tz61/ECE385FA24-PCB-ChampaignBoard/xc7s50-ece385-sch-v0.1.pdf

# XC7S50 Bank0

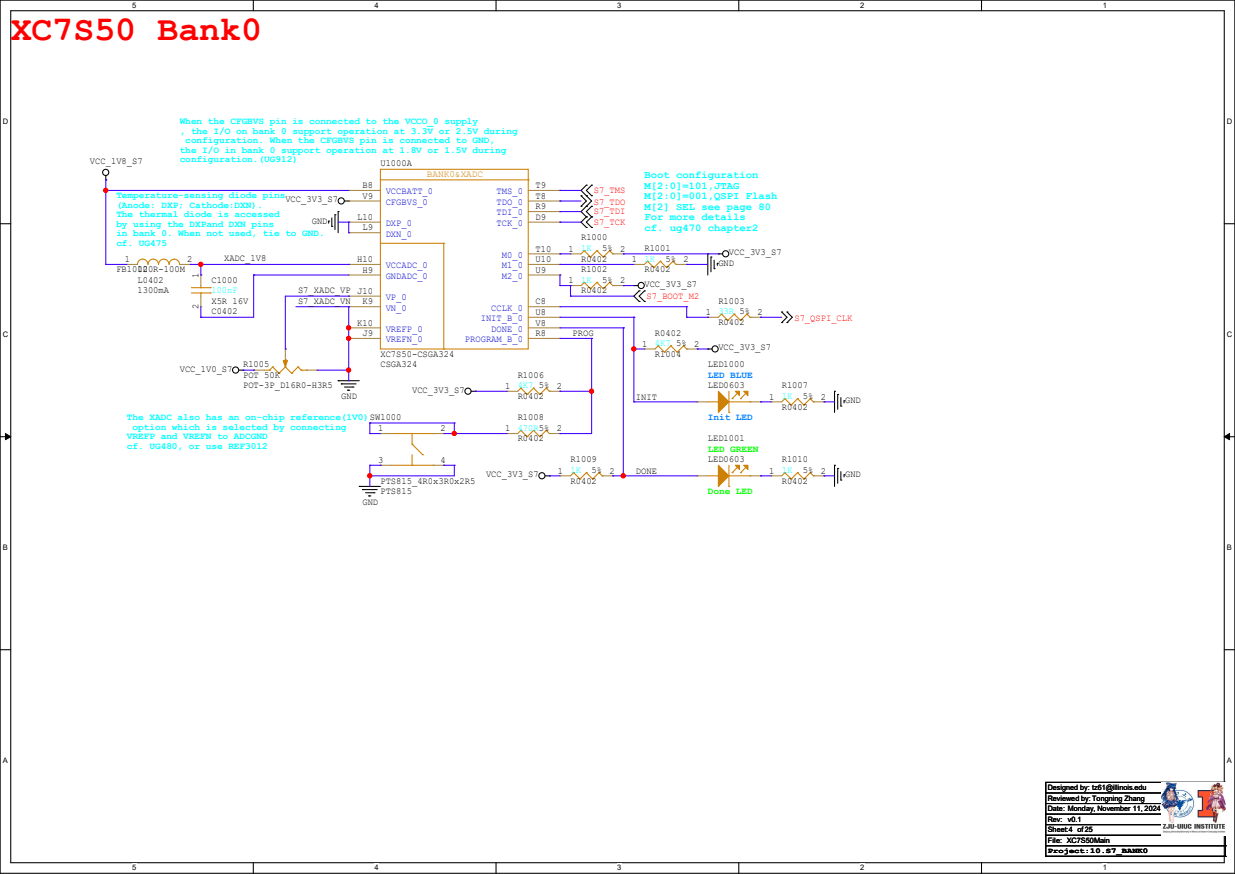
[picture p2: page 1]

When the CFGBVS pin is connected to the VCCO_0 supply
, the I/O on bank 0 support operation at 3.3V or 2.5V during
configuration. When the CFGBVS pin is connected to GND,
the I/O in bank 0 support operation at 1.8V or 1.5V during
configuration.(UG912)

Temperature-sensing diode pins
(Anode: DXP; Cathode:DXN).
The thermal diode is accessed
by using the DXPand DXN pins
in bank 0. When not used, tie to GND.

The XADC also has an on-chip reference(1V0)
option which is selected by connecting
VREFP and VREFN to ADCGND
cf. UG480, or use REF3012

File: Date: Designed by: Rev: Sheet: of Reviewed by:
Monday, November 11, 2024

# XC7S50 Bank14/15/16

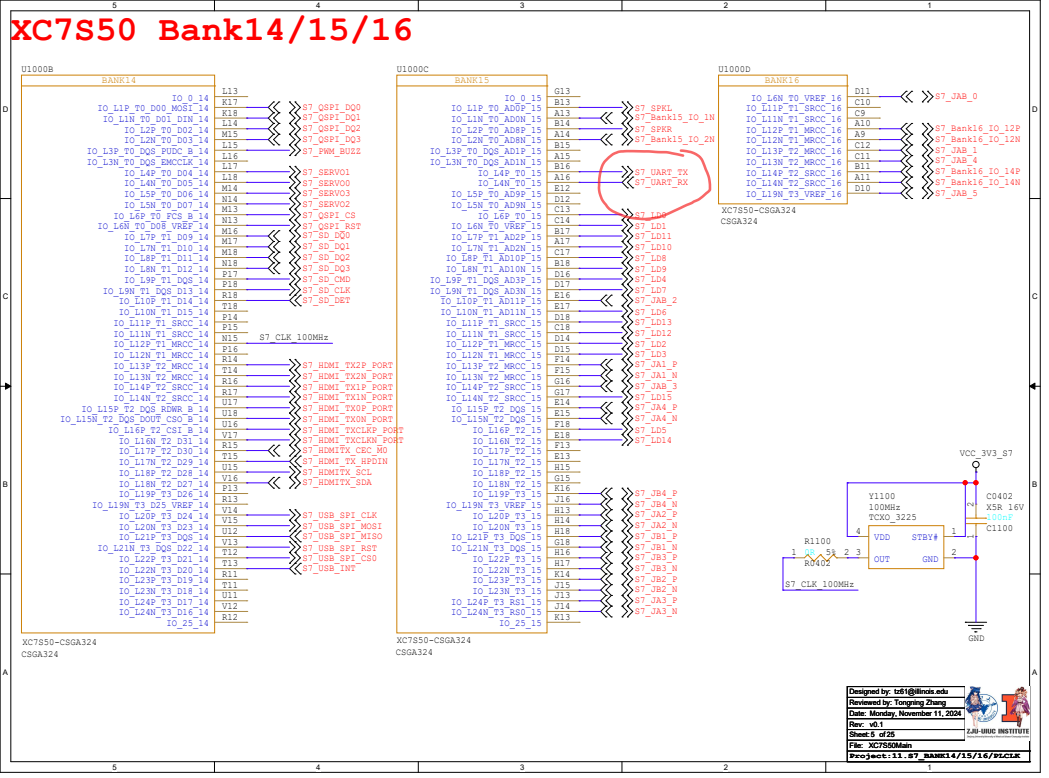
[picture p3: page 2]

File: Date: Designed by: Rev: Sheet: of Reviewed by:

# XC7S50 Bank34/35/DDRCLK

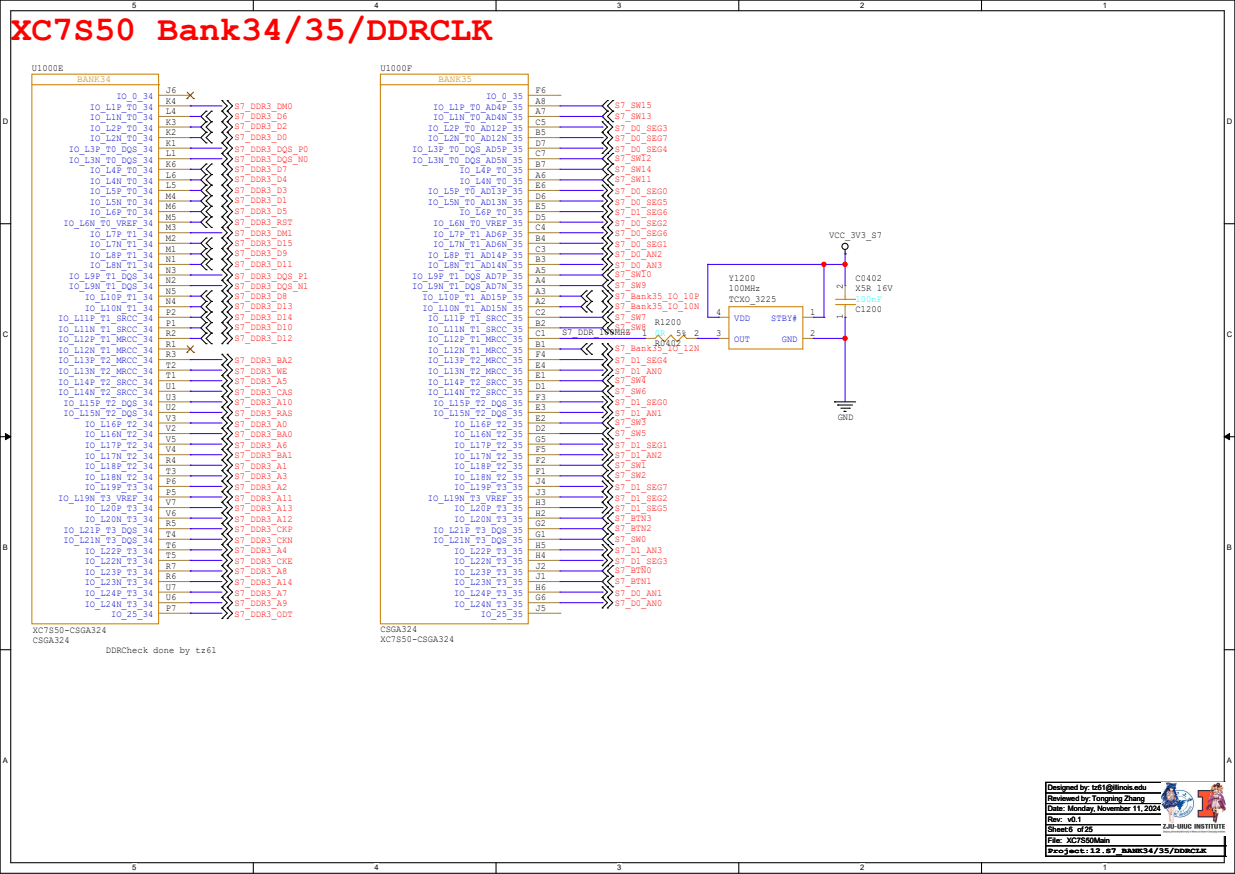
[picture p4: page 3]

File: Date: Designed by: Rev: Sheet: of Reviewed by:

# XC7S50 Power/Gnd

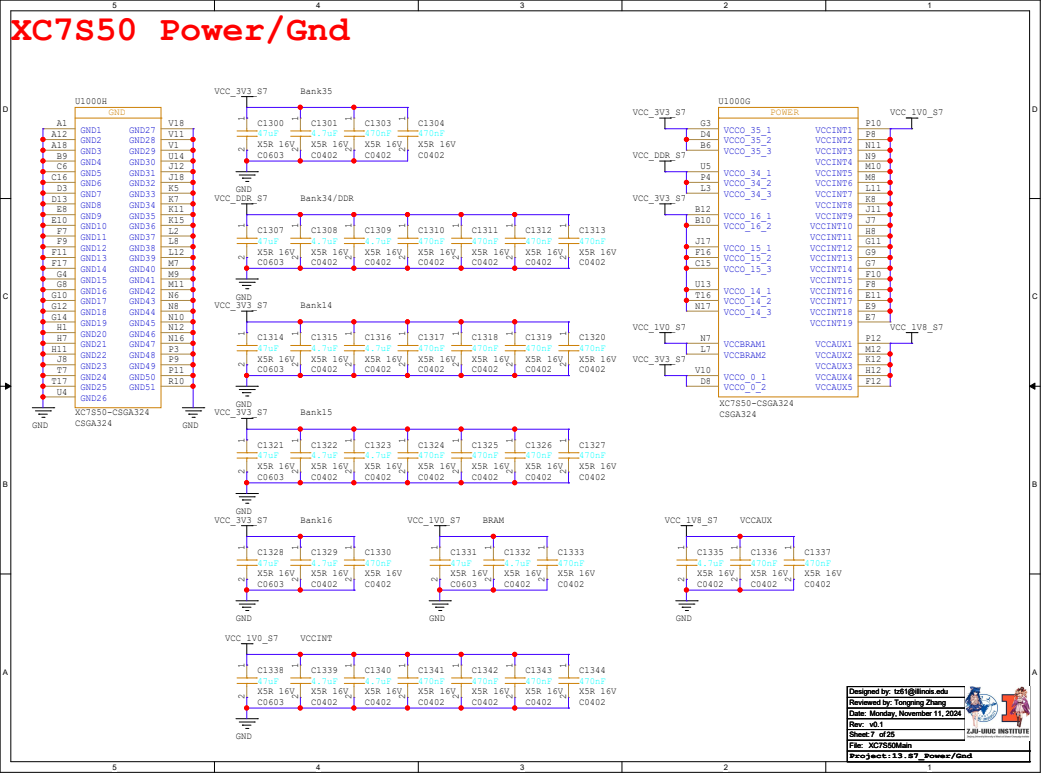
[picture p5: page 4]

File: Date: Designed by: Rev: Sheet: of Reviewed by:

# Power for Spartan7

# 5V Input/USB In(Type-C connector) GND

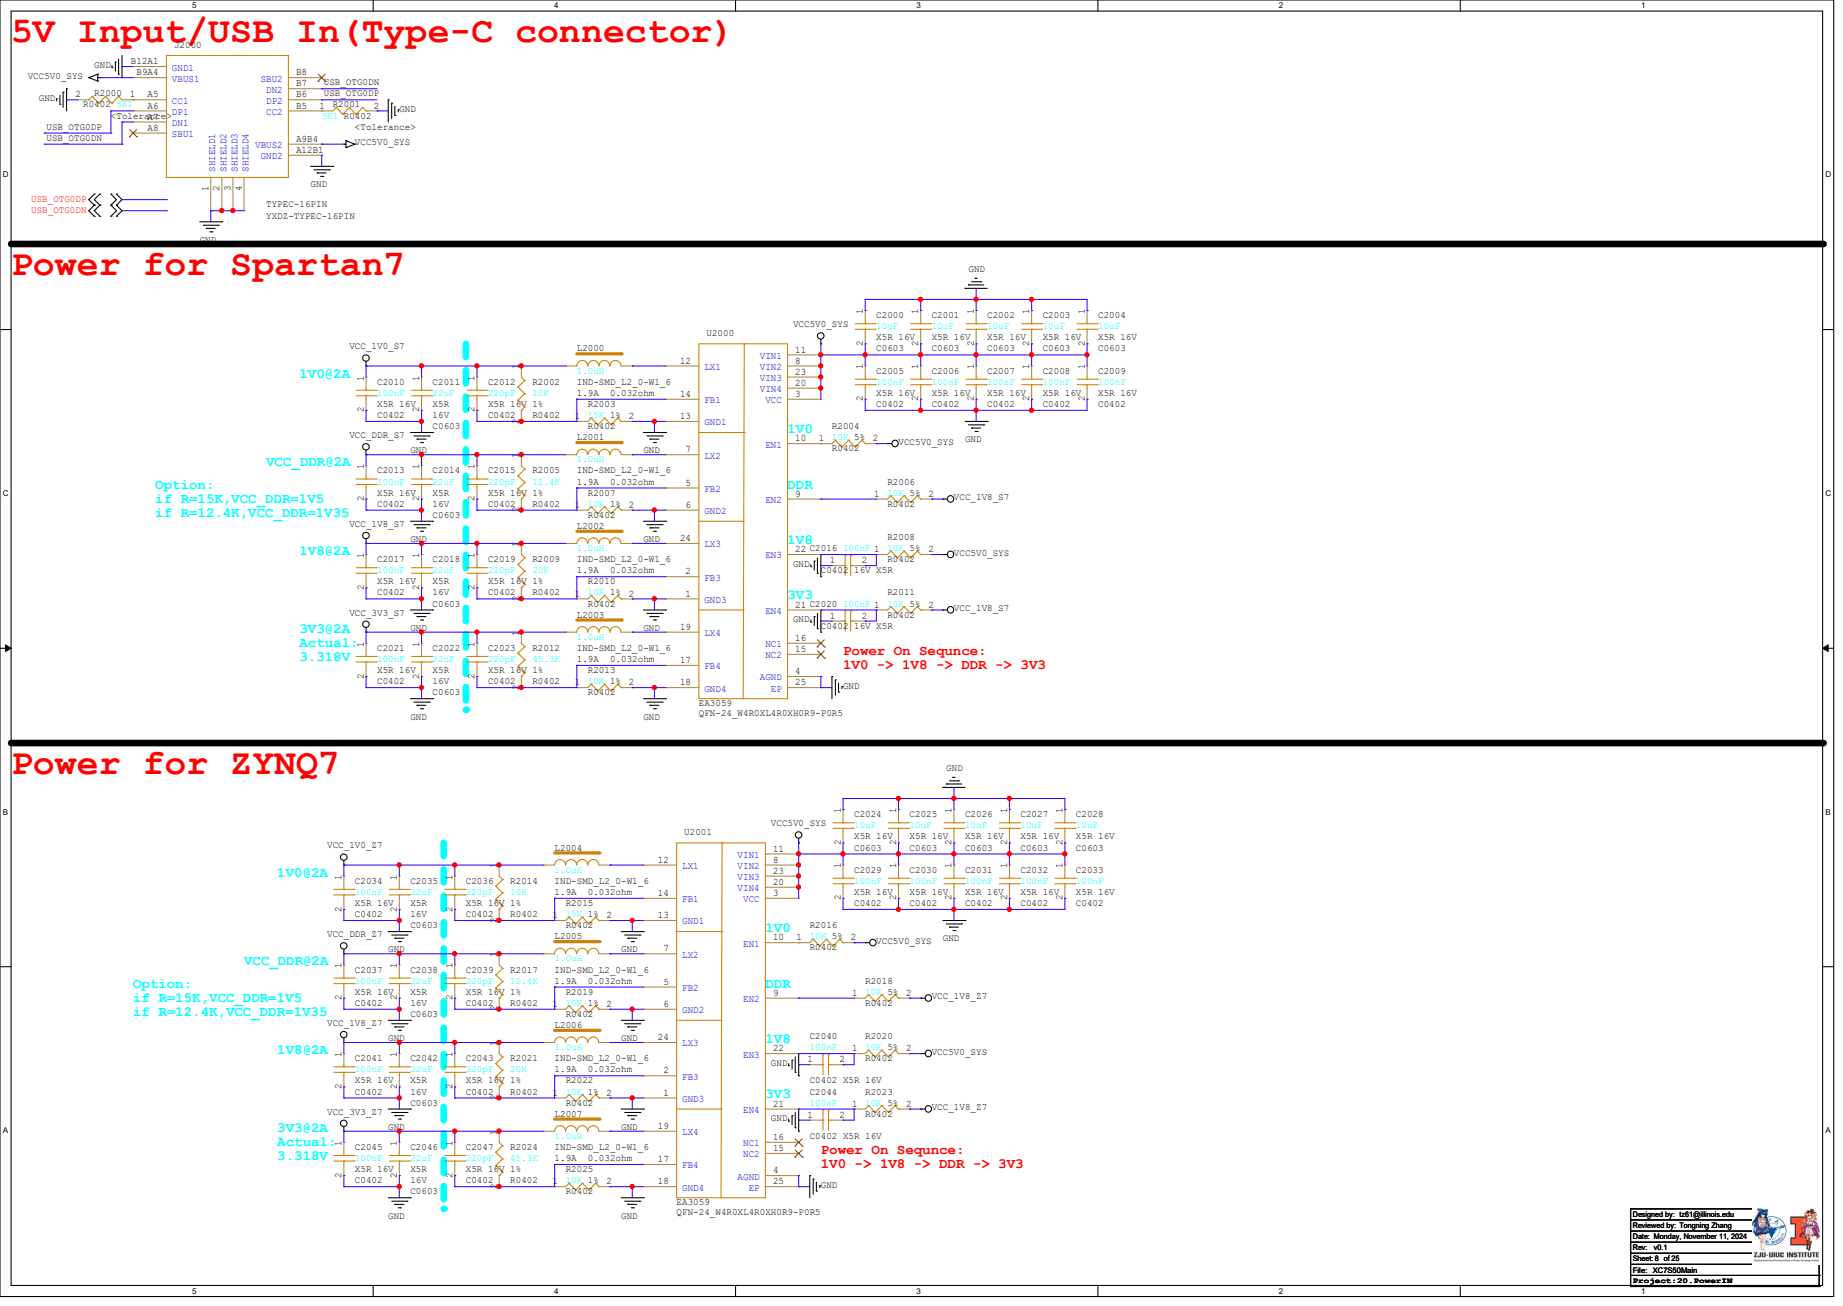
[picture p6: page 5]

# FT2232_HQ JTAG Debugger/UART

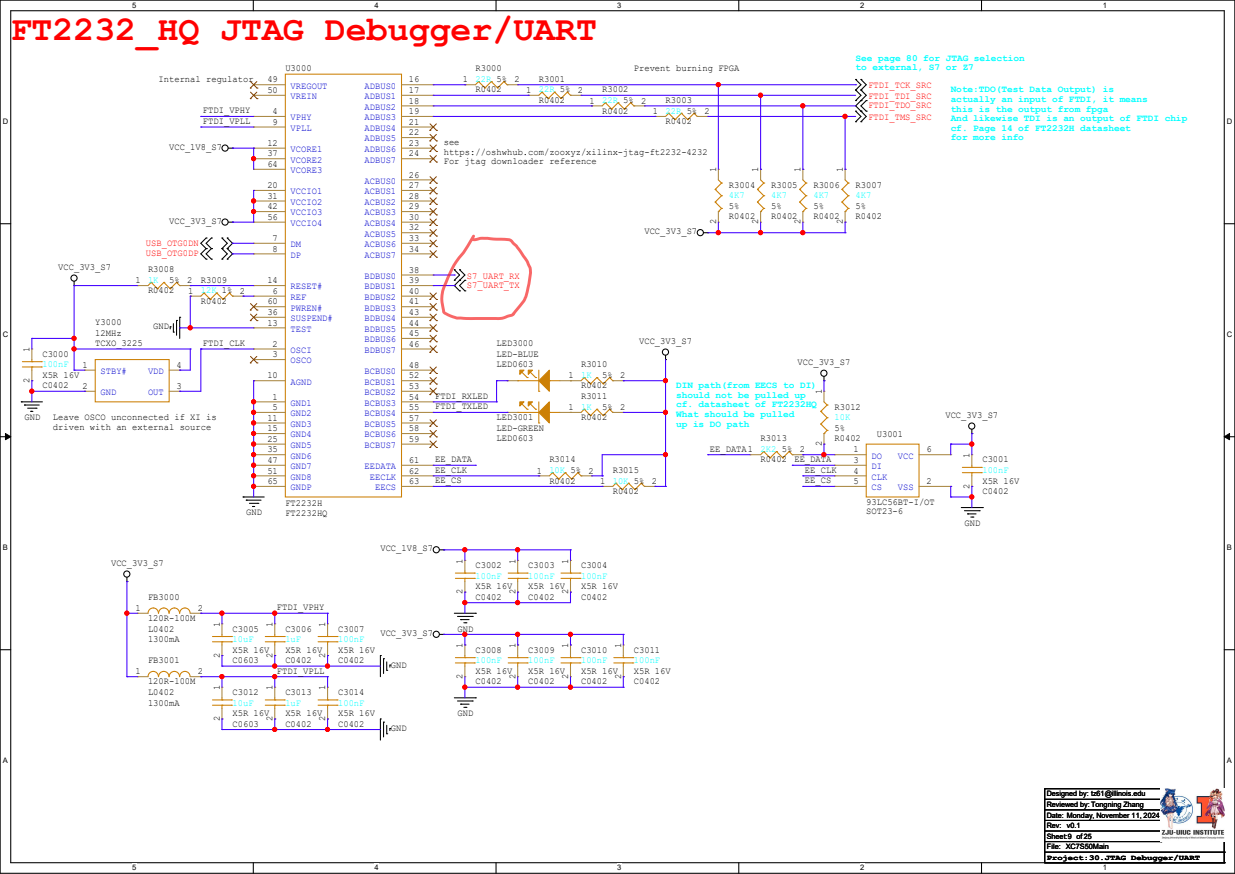
[picture p7: page 6]

See page 80 for JTAG selection

Note:TDO(Test Data Output) is
actually an input of FTDI, it means
this is the output from fpga
And likewise TDI is an output of FTDI chip
cf. Page 14 of FT2232H datasheet
for more info

https://oshwhub.com/zooxyz/xilinx-jtag-ft2232-4232
For jtag downloader reference

DIN path(from EECS to DI)
should not be pulled up
cf. datasheet of FT2232HQ
What should be pulled
up is DO path

Leave OSCO unconnected if XI is
driven with an external source

File: Date: Designed by: Rev: Sheet: of Reviewed by:

XC7S50 DDR3/DDR3L | Decoupling Capacitors

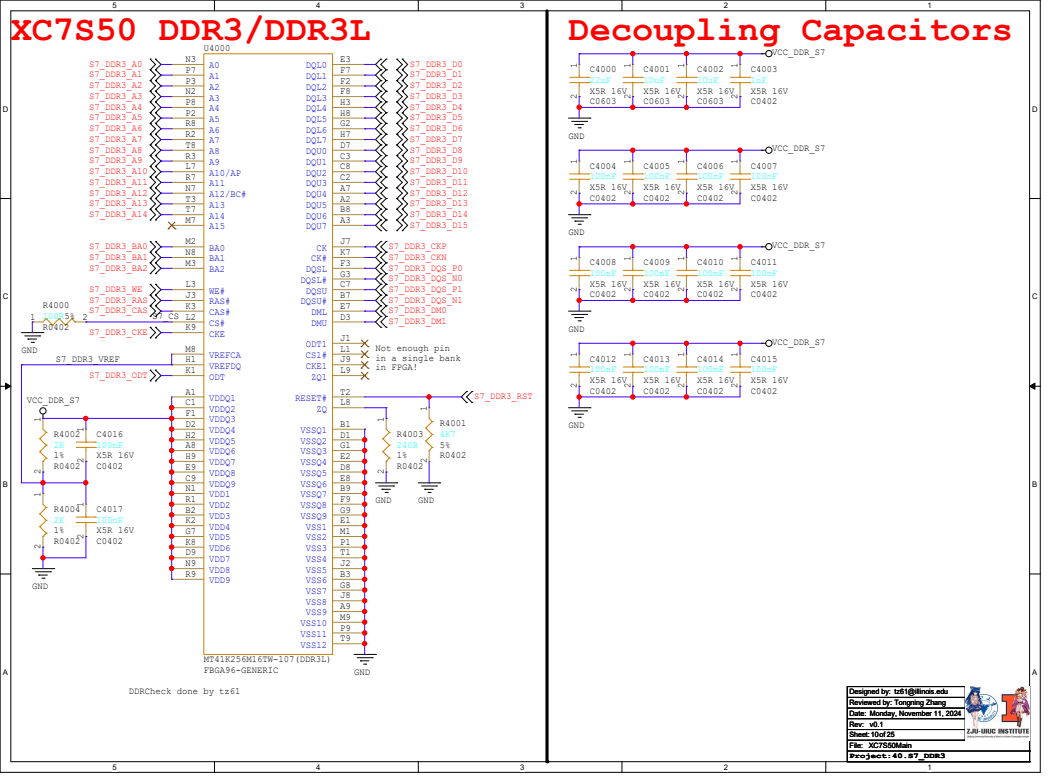
[picture p8: page 7]

File: Date: Designed by: Rev: Sheet: of Reviewed by:

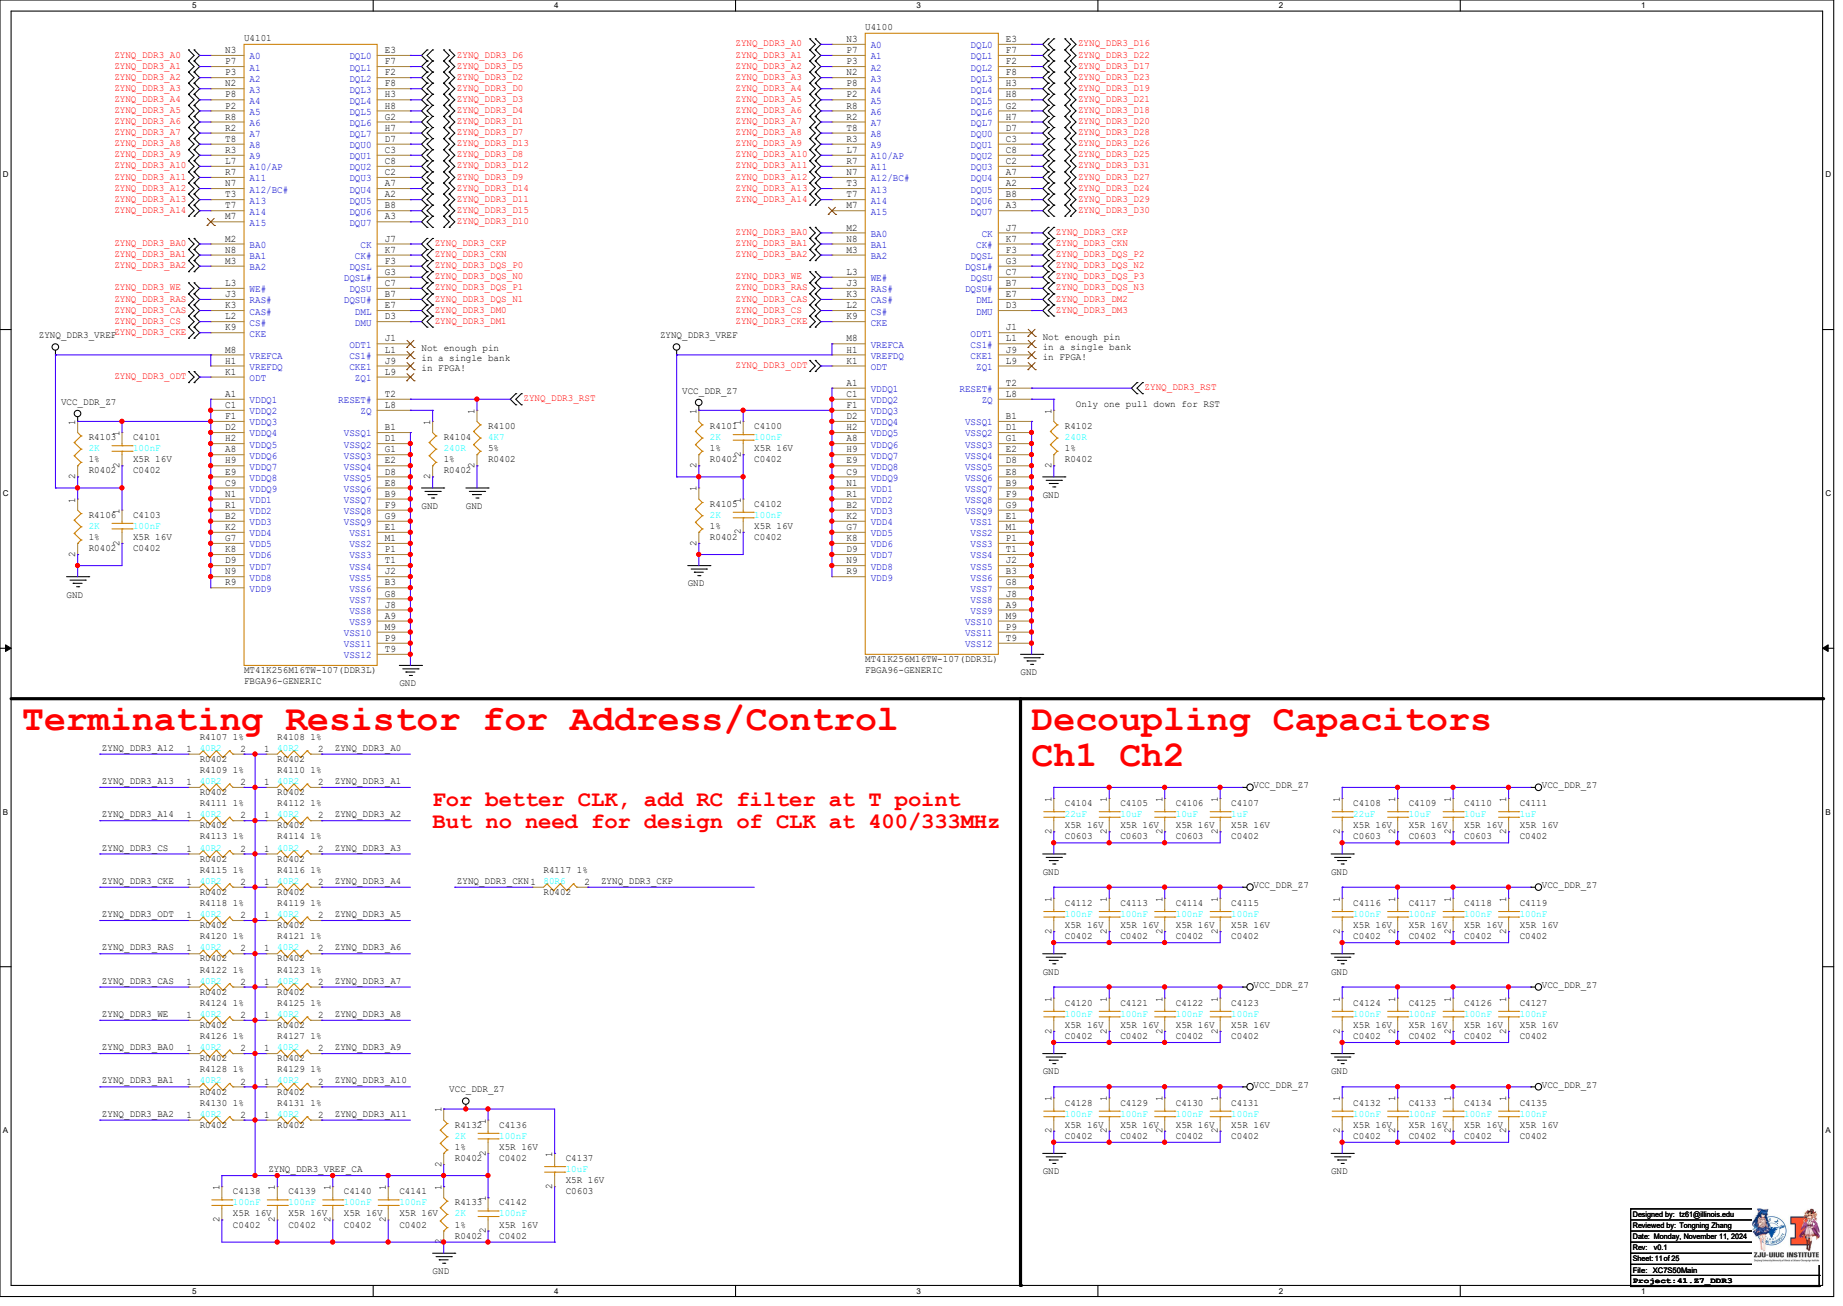
[picture p9: page 8]

Only one pull down for RST

Terminating Resistor for Address/Control

For better CLK, add RC filter at T point
But no need for design of CLK at 400/333MHz

## When the CFGBVS pin is connected to the VCCO_0 supply , the I/O on bank 0 support operation at 3.3V or 2.5V during

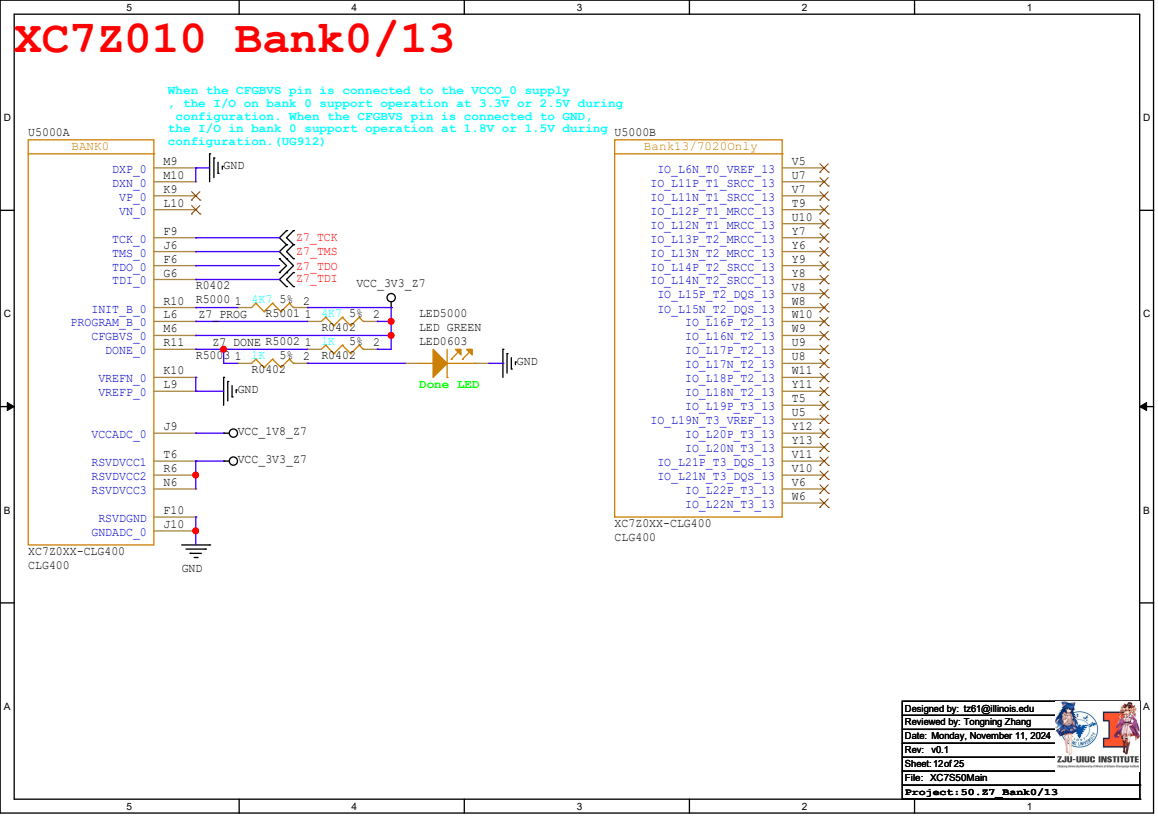
[picture p10: page 9]
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

# XC7Z010 Bank34/35

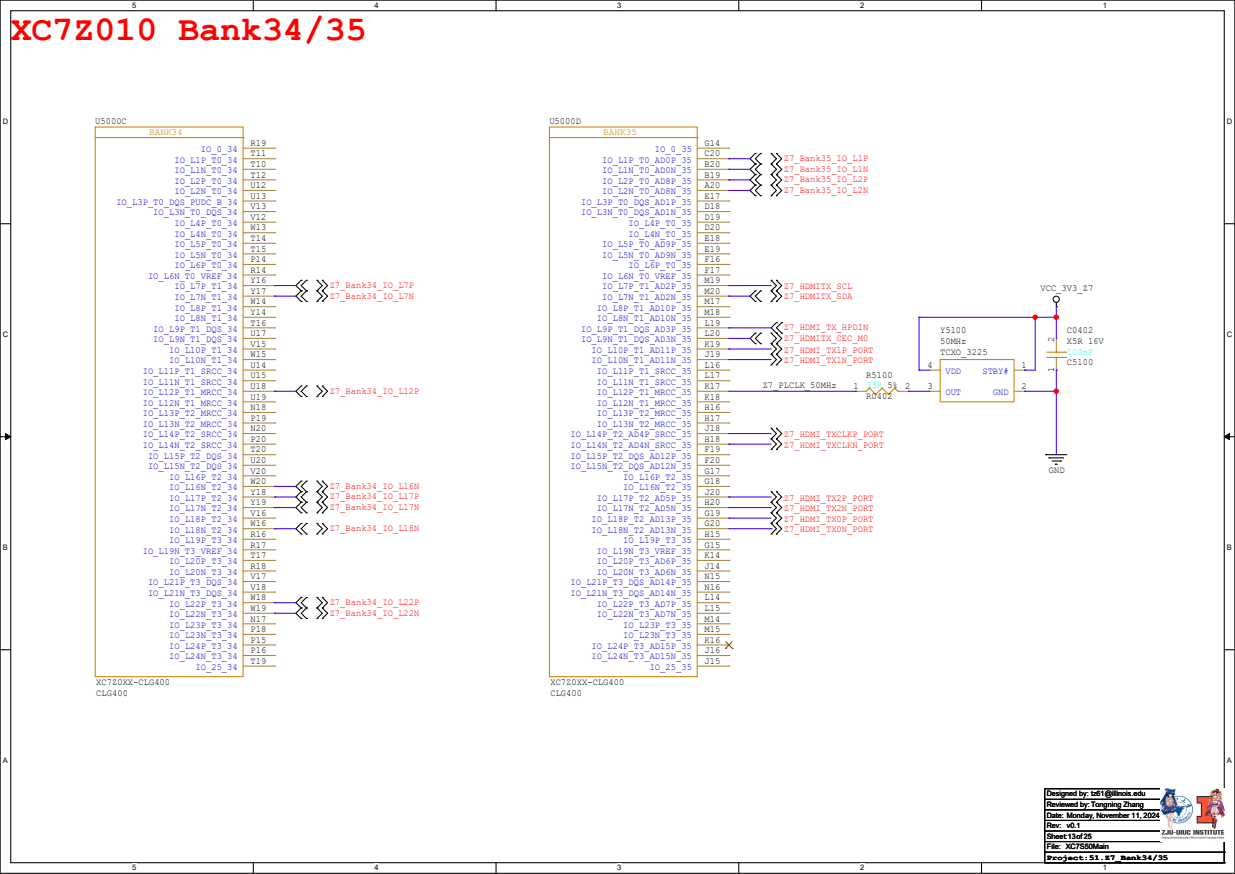
[picture p11: page 10]

File: Date: Designed by: Rev: Sheet: of Reviewed by:

D D

# Reset Signal

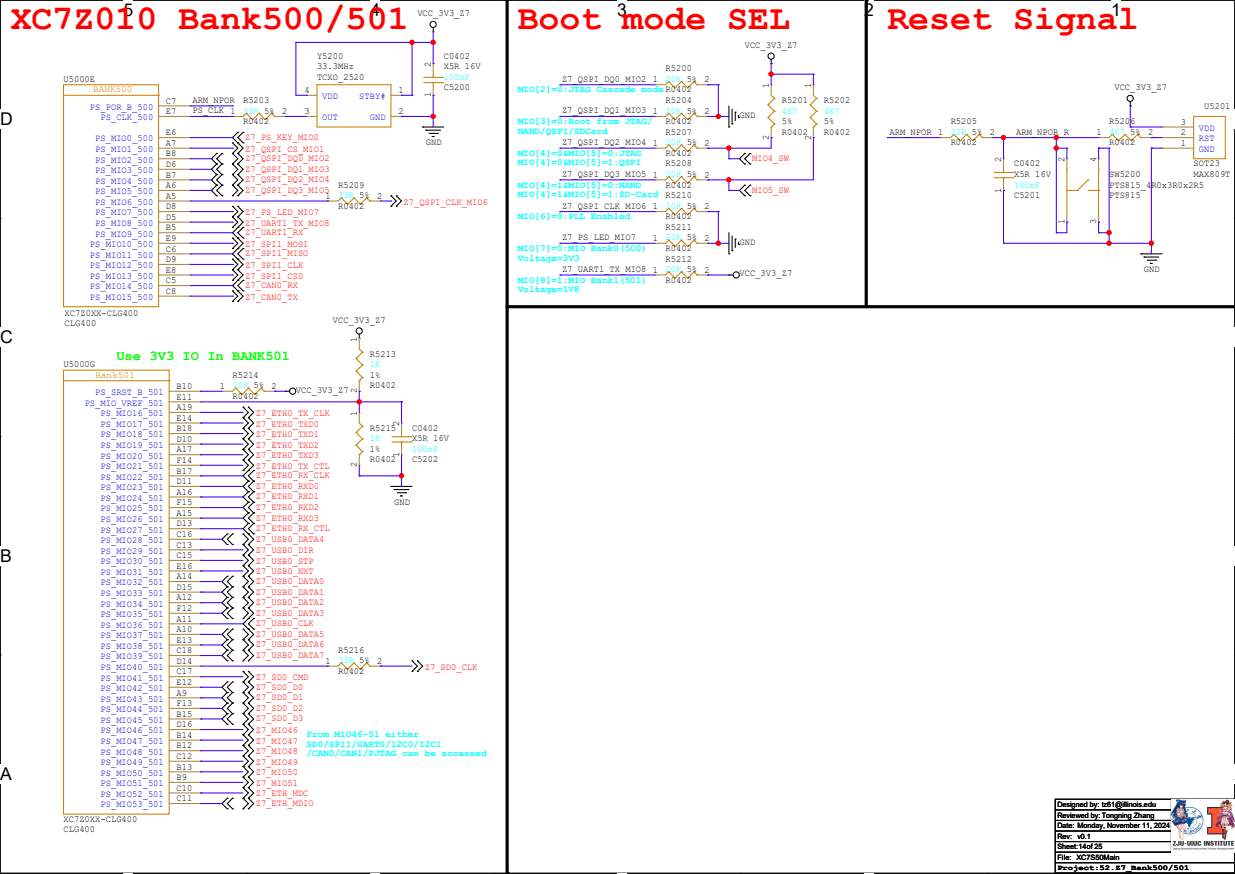
[picture p12: page 11]

MIO[2]=0:JTAG Cascade mode

MIO[3]=0:Boot from JTAG/
NAND/QSPI/SDCard

MIO[4]=1&MIO[5]=0:NAND
MIO[4]=1&MIO[5]=1:SD-Card

From MIO46-51 either
SD0/SPI1/UART0/I2C0/I2C1
/CAN0/CAN1/PJTAG can be accessed

File: Date: Designed by: Rev: Sheet: of Reviewed by:

D D

## Dont' exchange DQ net here

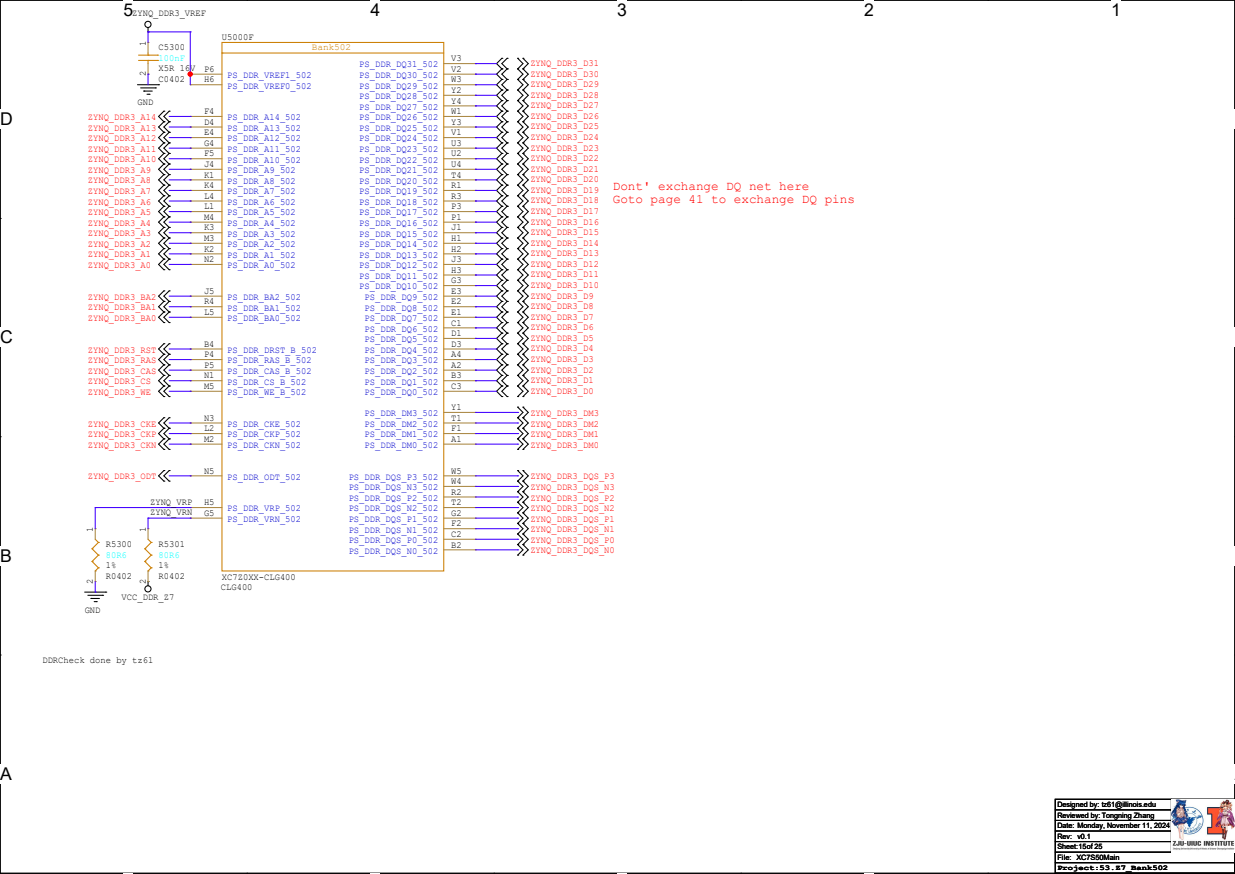
[picture p13: page 12]

Goto page 41 to exchange DQ pins

File: Date: Designed by: Rev: Sheet: of Reviewed by:

D D

XC7Z010 Power/Gnd | DDR/Bank502

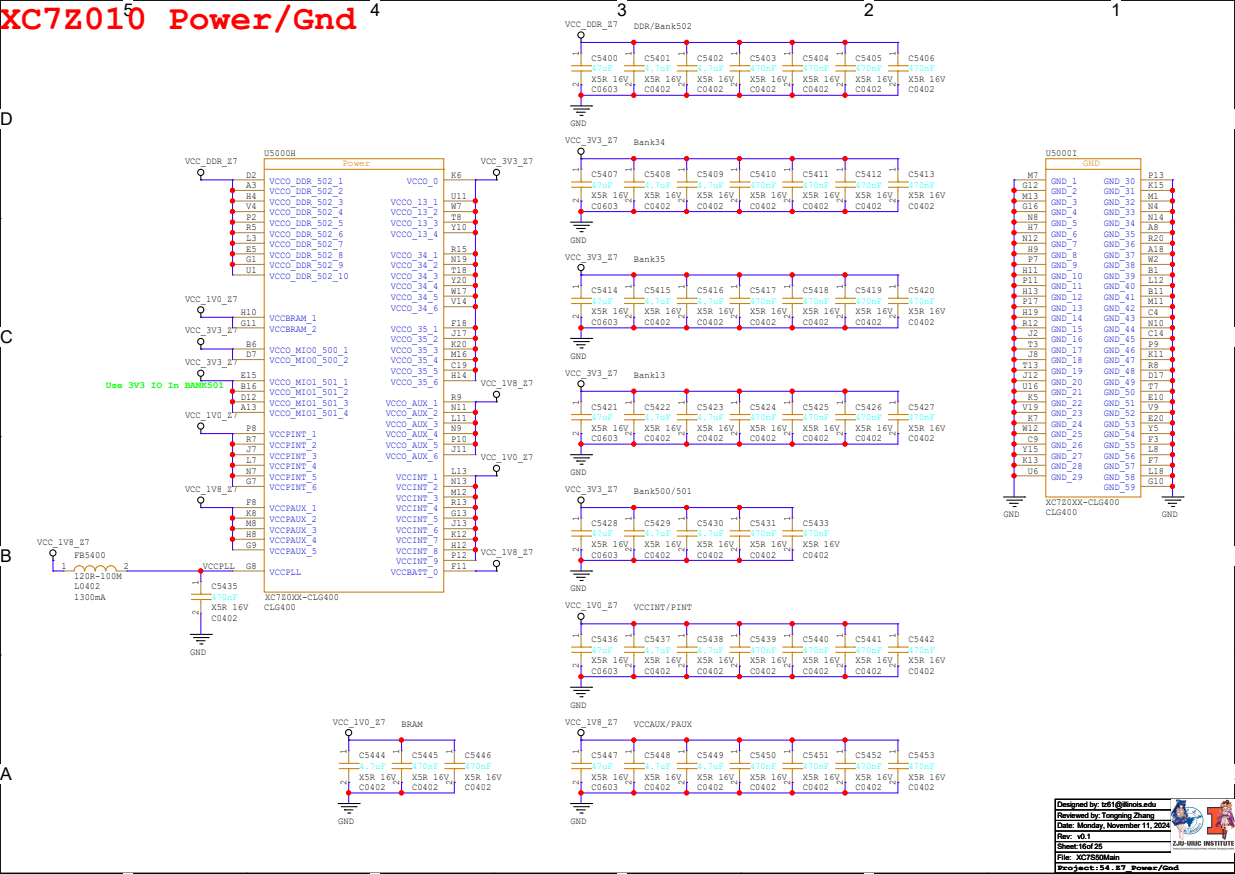
[picture p14: page 13]

File: Date: Designed by: Rev: Sheet: of Reviewed by:

D D

# XC7S50 SPI USB Host(MAX3421)

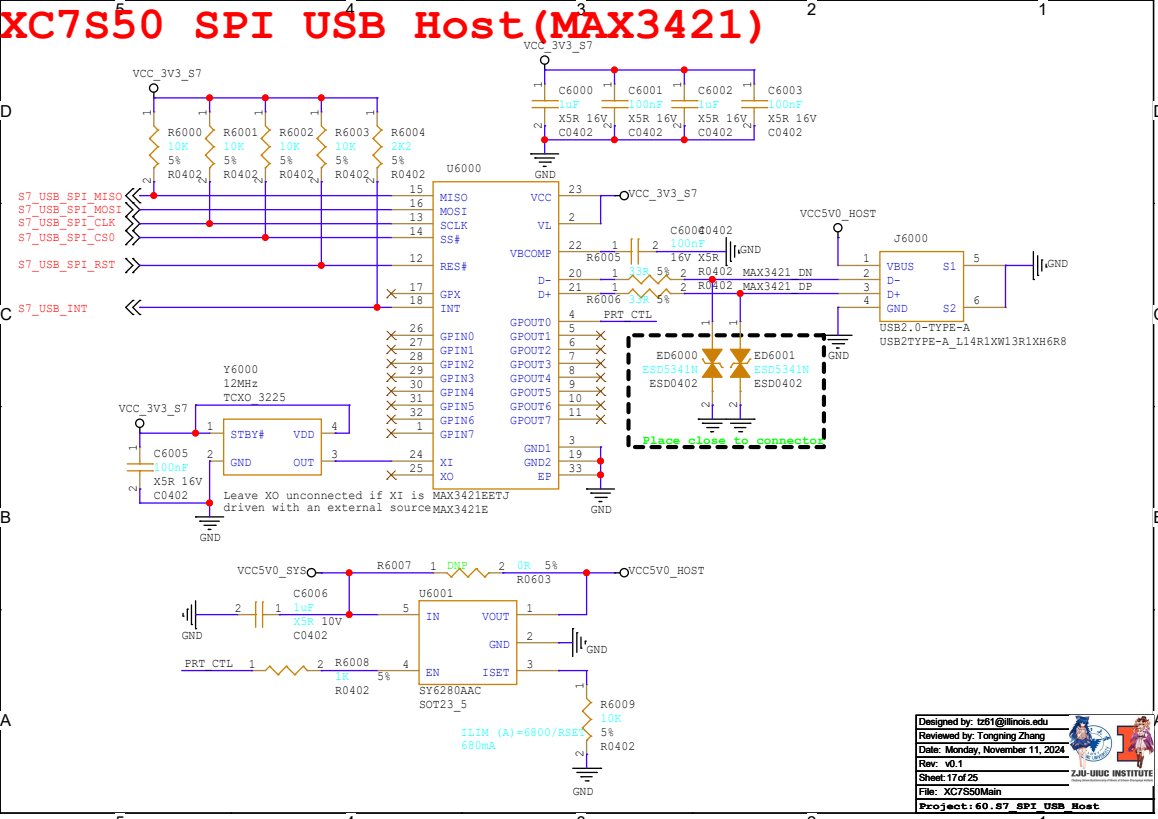
[picture p15: page 14]

Place close to connector

Leave XO unconnected if XI is
driven with an external source

D D

# XC7S50 Audio/Buzzer

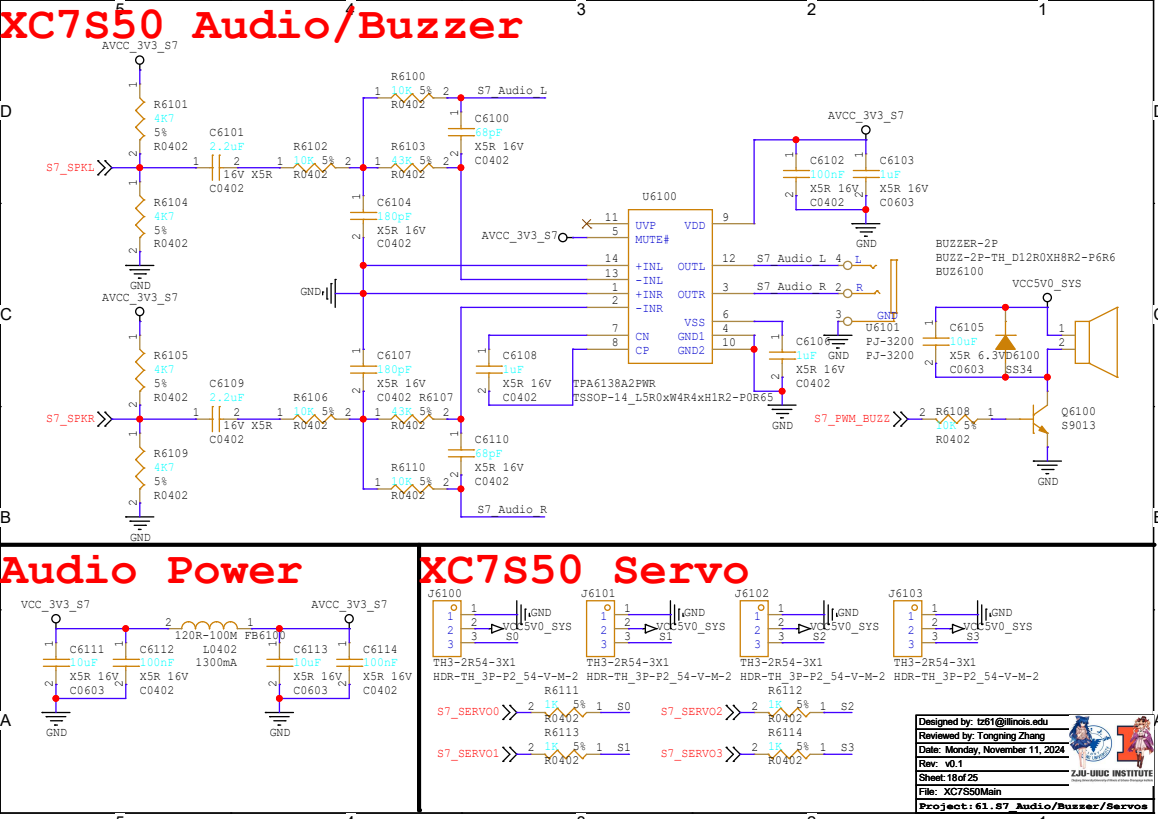
[picture p16: page 15]

D D

# XC7S50 QSPI Flash

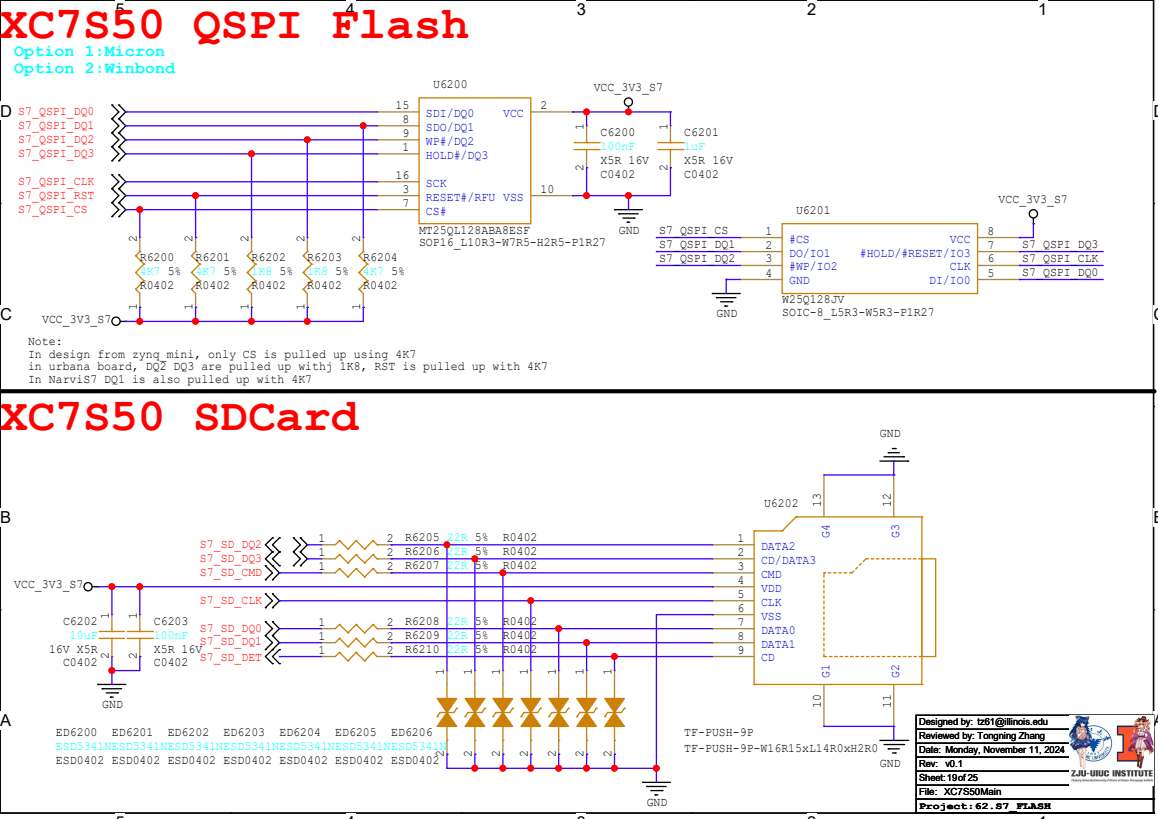
[picture p17: page 16]

VCC_3V3_S7
Note:
In design from zynq_mini, only CS is pulled up using 4K7
in urbana board, DQ2 DQ3 are pulled up withj 1K8, RST is pulled up with 4K7
In NarviS7 DQ1 is also pulled up with 4K7
XC7S50 SDCard

D D

# XC7S50 HDMI TX

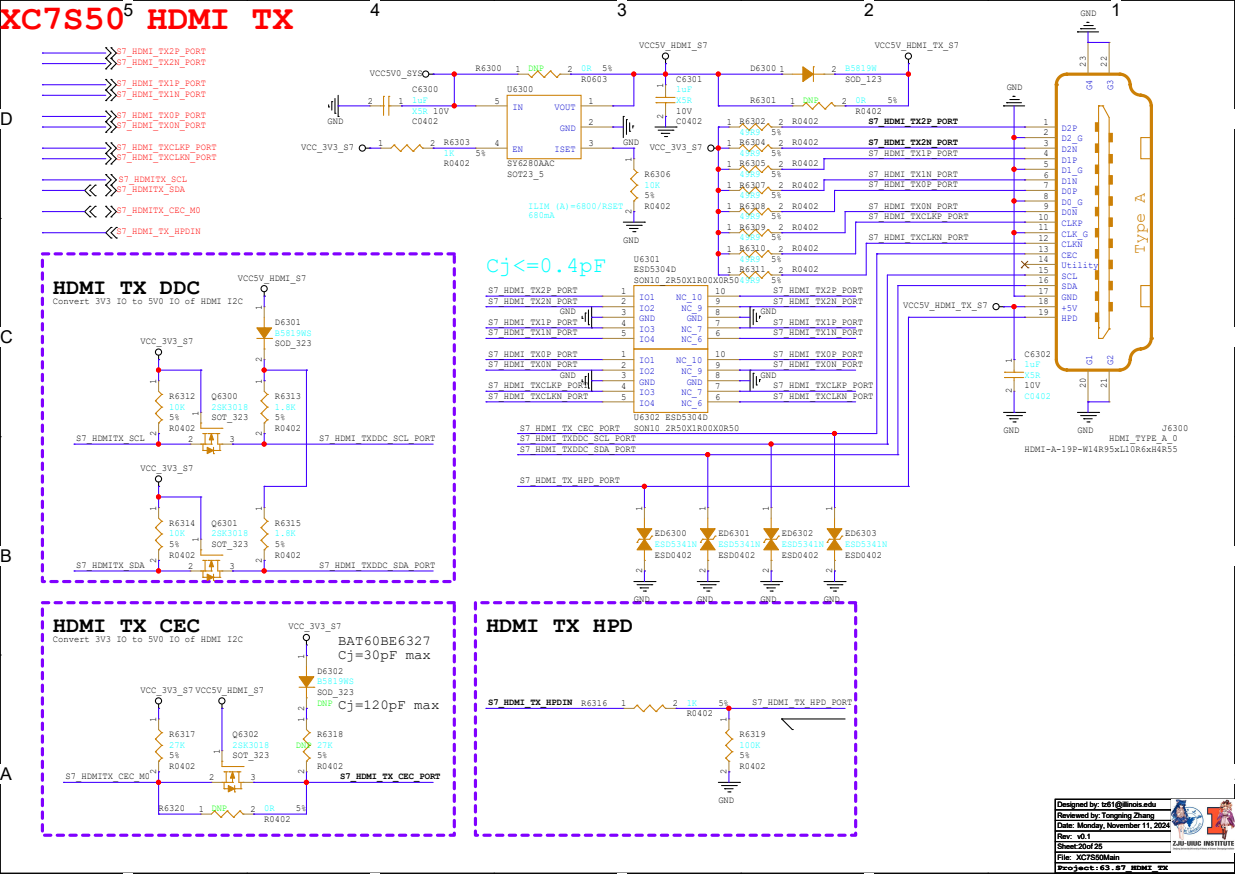
[picture p18: page 17]

Cj<=0.4pF Convert 3V3 IO to 5V0 IO of HDMI I2C
HDMI TX DDC

HDMI TX CEC
Convert 3V3 IO to 5V0 IO of HDMI I2C

File: Date: Designed by: Rev: Sheet: of Reviewed by:

D D

# XC7Z010 HDMI TX

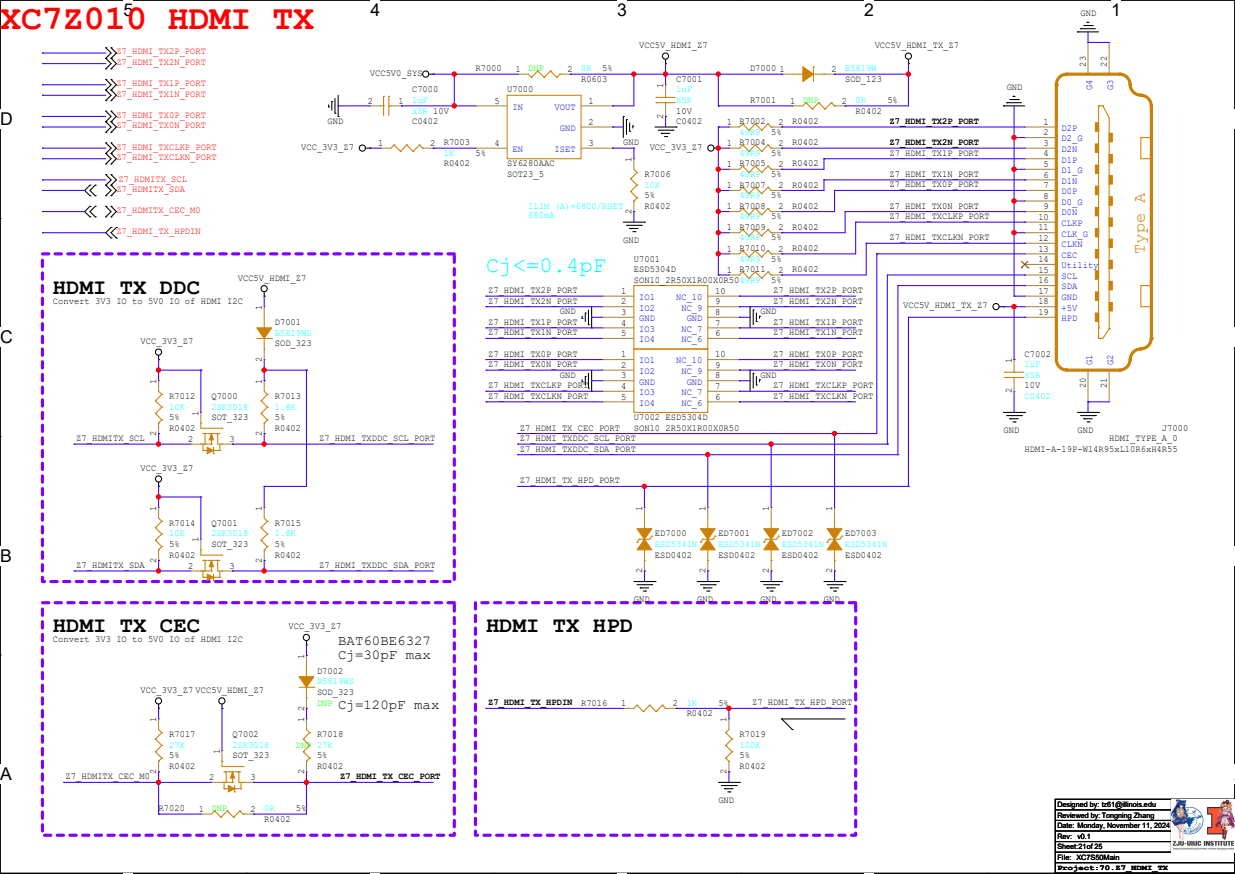
[picture p19: page 18]

HDMI TX DDC
Convert 3V3 IO to 5V0 IO of HDMI I2C

HDMI TX CEC

File: Date: Designed by: Rev: Sheet: of Reviewed by:

D D

# XC7Z010 QSPI Flash

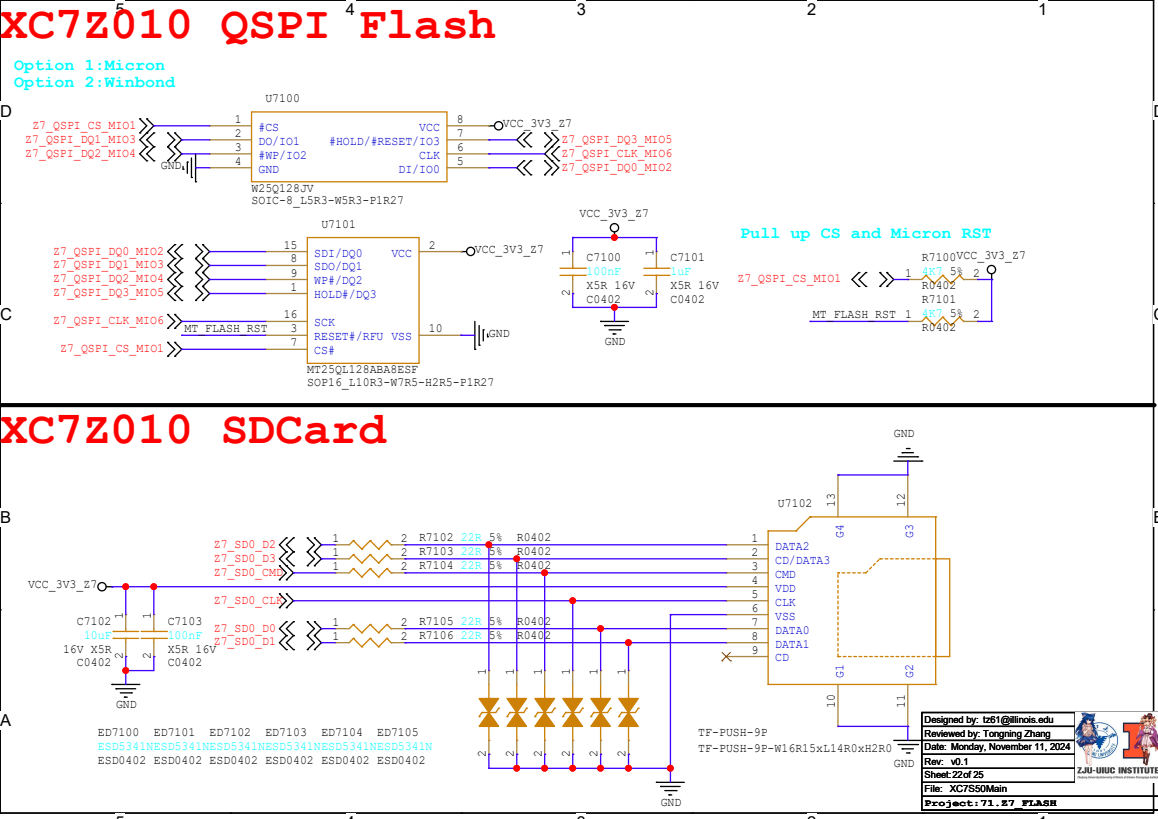
[picture p20: page 19]

Pull up CS and Micron RST

D

D

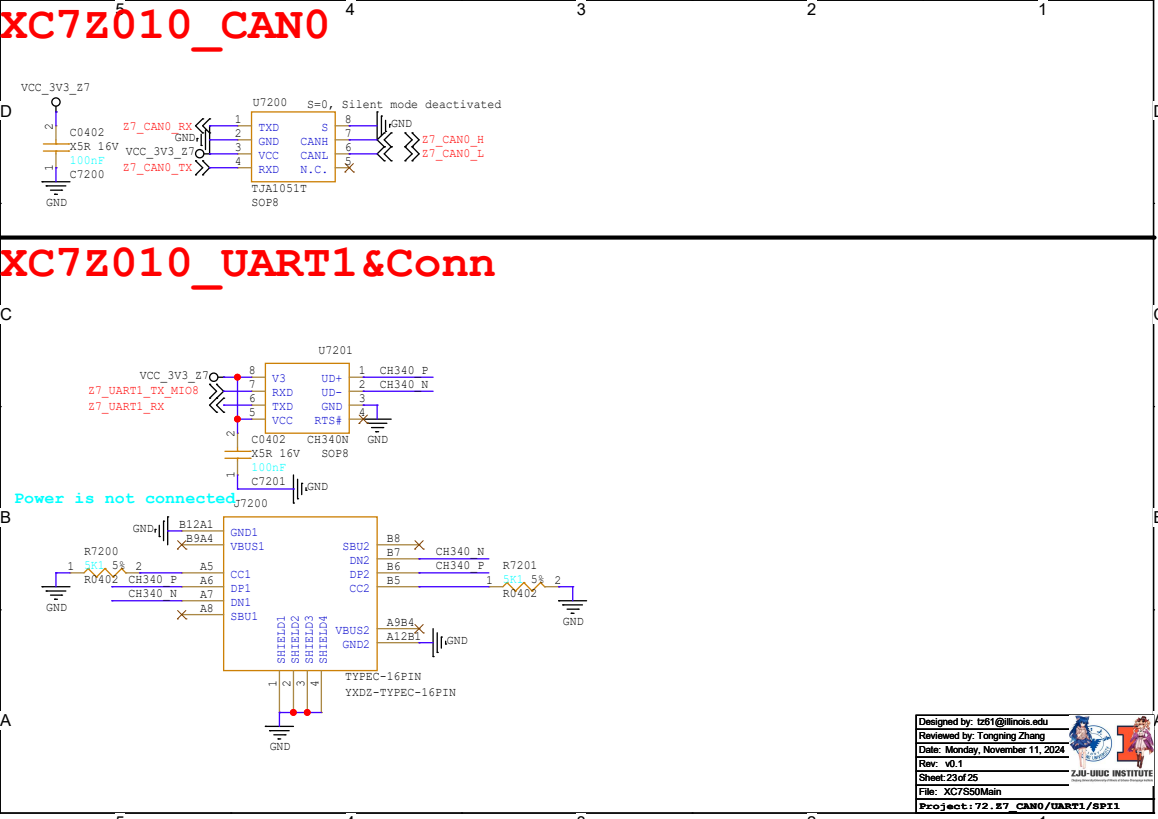
[picture p21: page 20]

Power is not connected

D D

# XC7Z010 GMAC+PHY

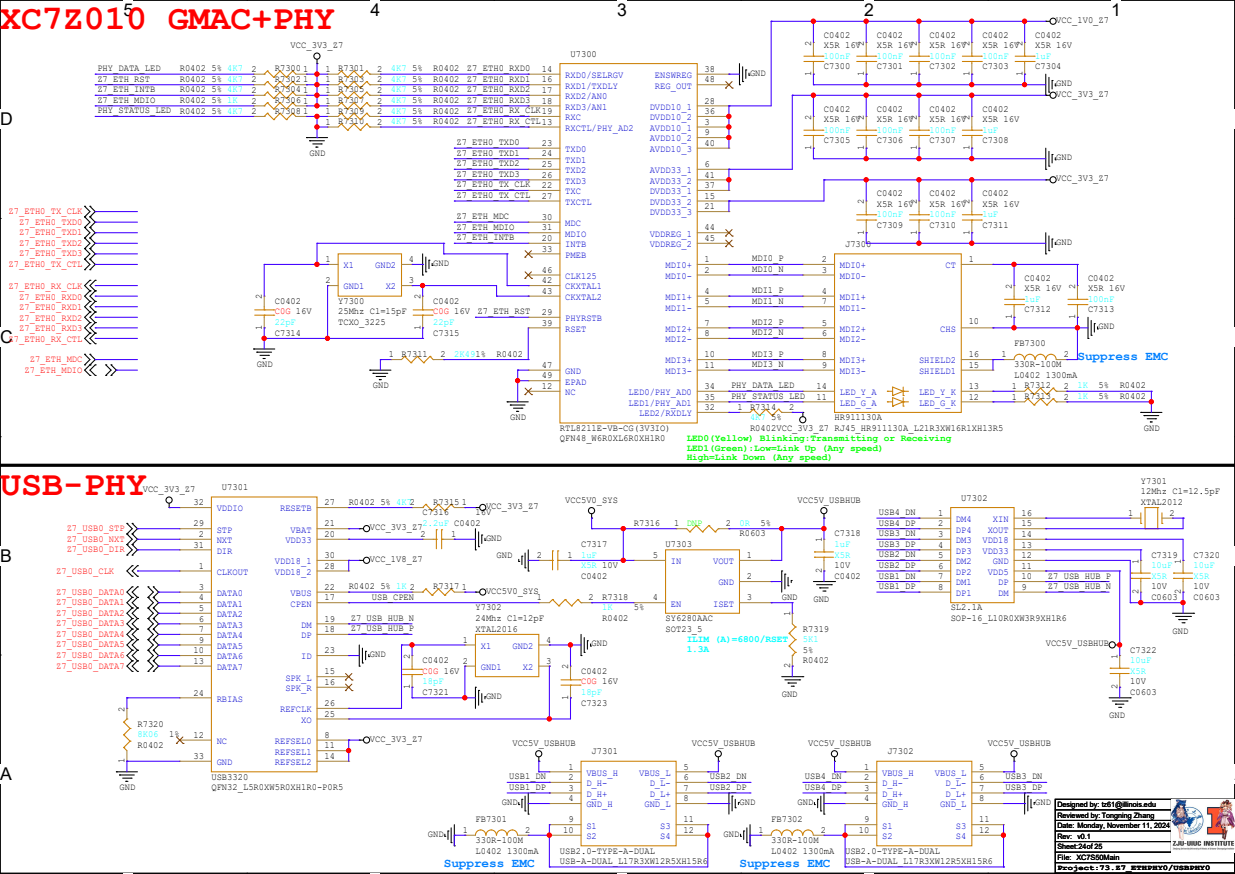
[picture p22: page 21]

LED0(Yellow) Blinking:Transmitting or Receiving
LED1(Green):Low=Link Up (Any speed)
High=Link Down (Any speed)

File: Date: Designed by: Rev: Sheet: of Reviewed by:

D D

# Overall Keys/LED/Switches/PMODs

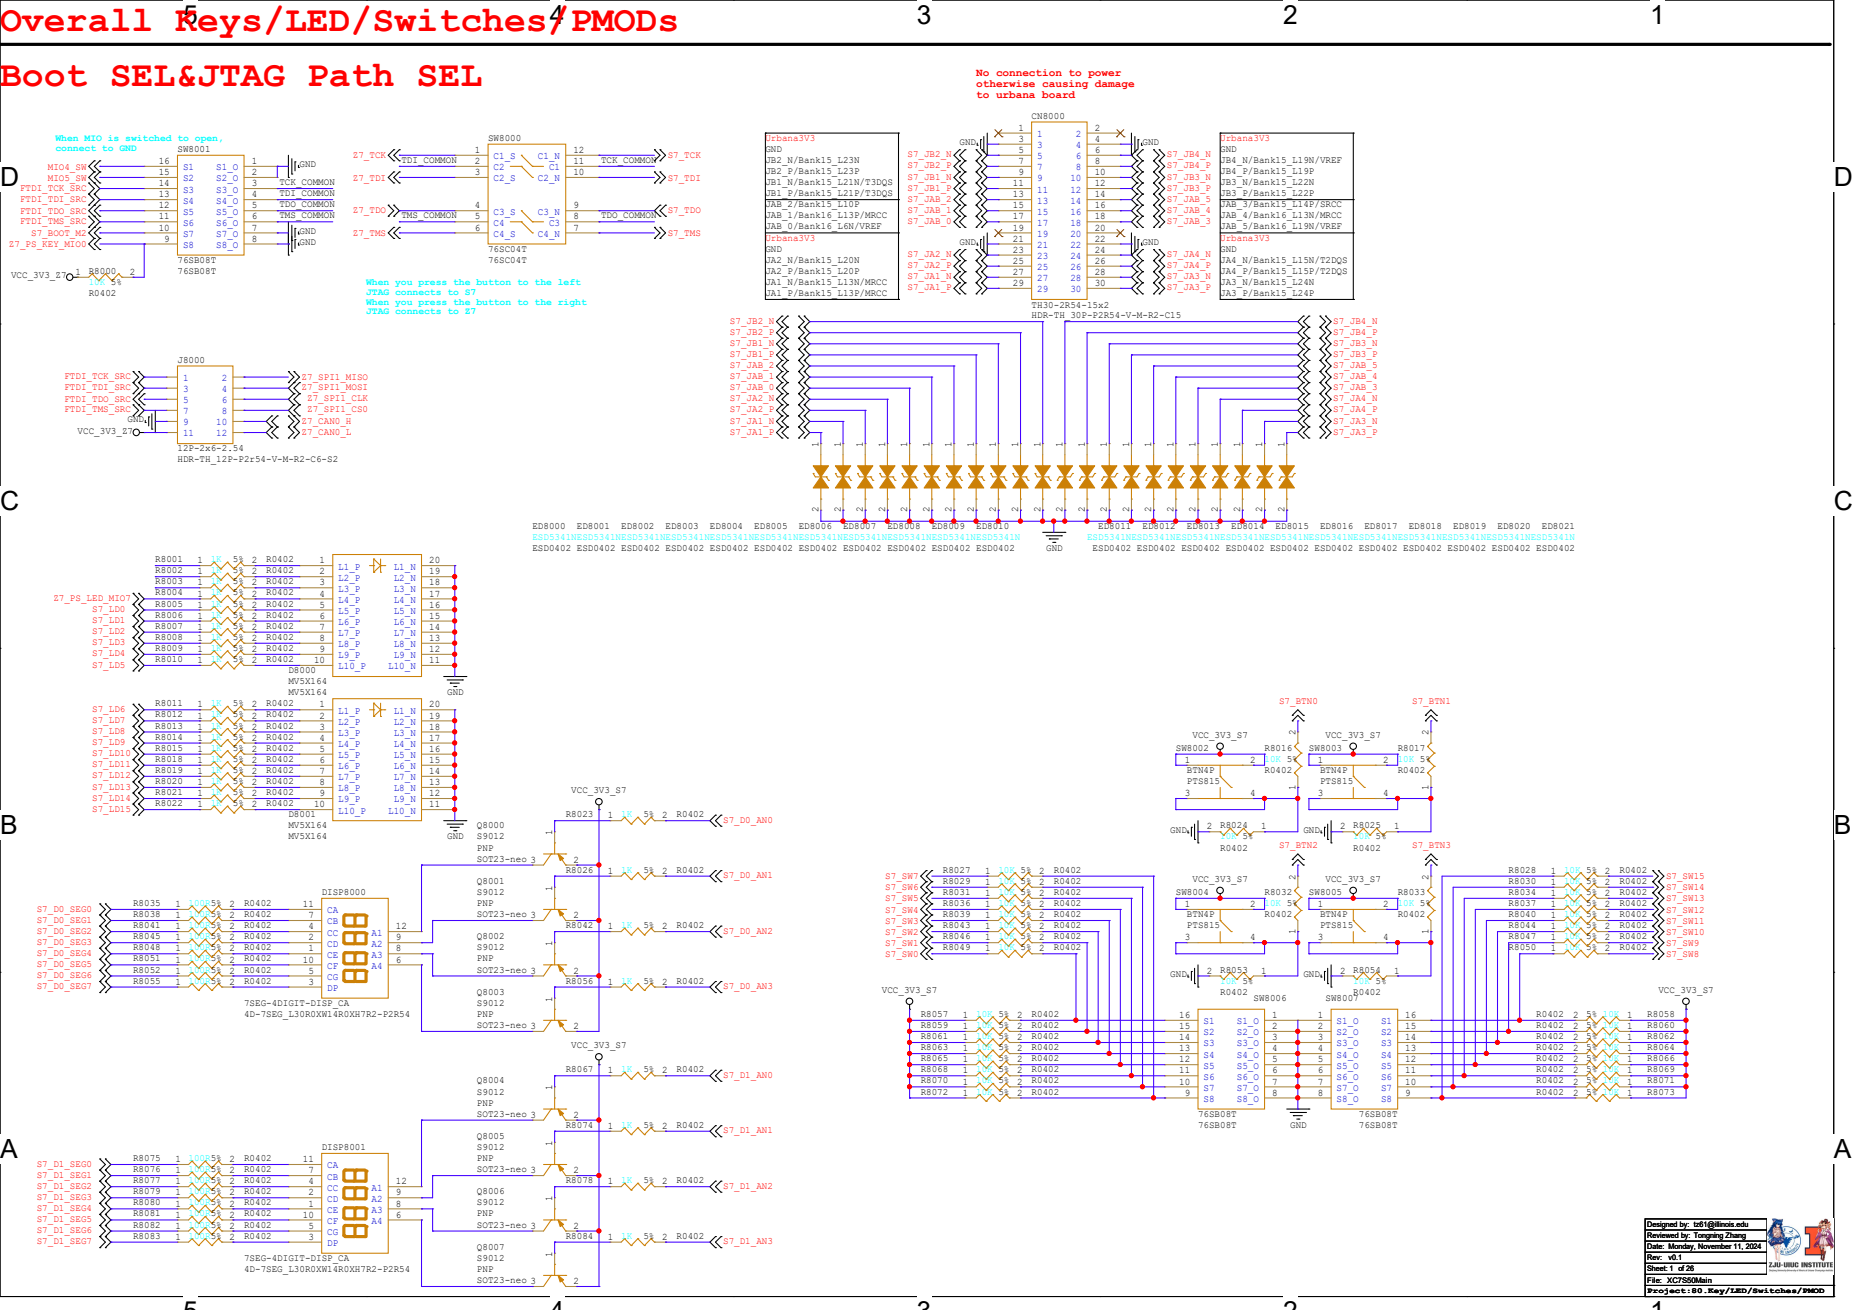
[picture p23: page 22]

No connection to power
otherwise causing damage

to urbana board GND

When you press the button to the left
JTAG connects to S7
When you press the button to the right
JTAG connects to Z7

D D

# XC7Z010 IO Extension

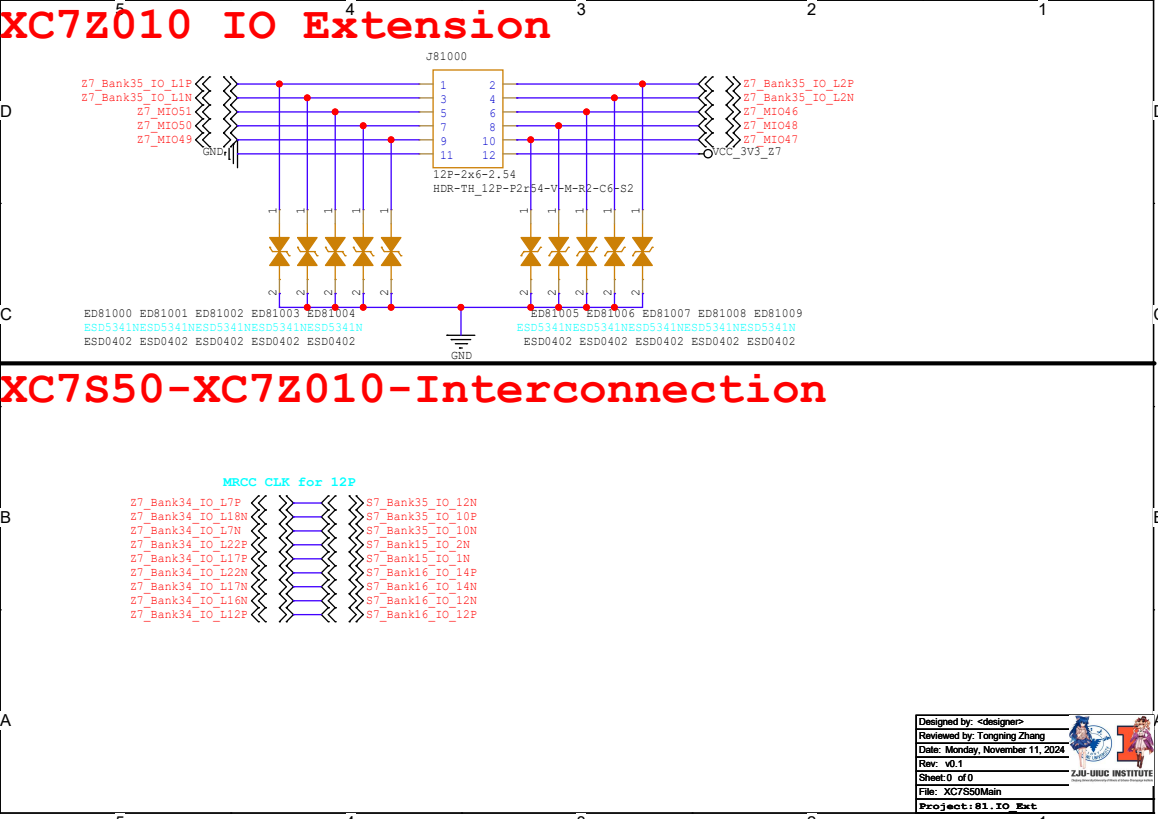
[picture p24: page 23]
XC7S50-XC7Z010-Interconnection; GND; VCC_3V3_Z7; Z7_Bank34_IO_L7P; S7_Bank35_IO_12N; Z7_Bank34_IO_L18N Z7_Bank34_IO_L7N Z7_Bank34_IO_L22P Z7_Bank34_IO_L17P Z7_Bank34_IO_L22N Z7_Bank34_IO_L17N Z7_Bank34_IO_L16N Z7_Bank34_IO_L12P; S7_Bank35_IO_10P S7_Bank35_IO_10N S7_Bank15_IO_2N S7_Bank15_IO_1N S7_Bank16_IO_14P S7_Bank16_IO_14N S7_Bank16_IO_12N S7_Bank16_IO_12P; Z7_MIO46; Z7_MIO47; Z7_MIO48; Z7_MIO49; Z7_MIO50; Z7_MIO51; Z7_Bank35_IO_L1P Z7_Bank35_IO_L1N; Z7_Bank35_IO_L2P Z7_Bank35_IO_L2N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

MRCC CLK for 12P
